synfinatic/sv650sds/sds_tool/sds_tool.kicad_pcb

## KiCad design sds_tool/sds_tool.kicad_pcb (2017-03-15)

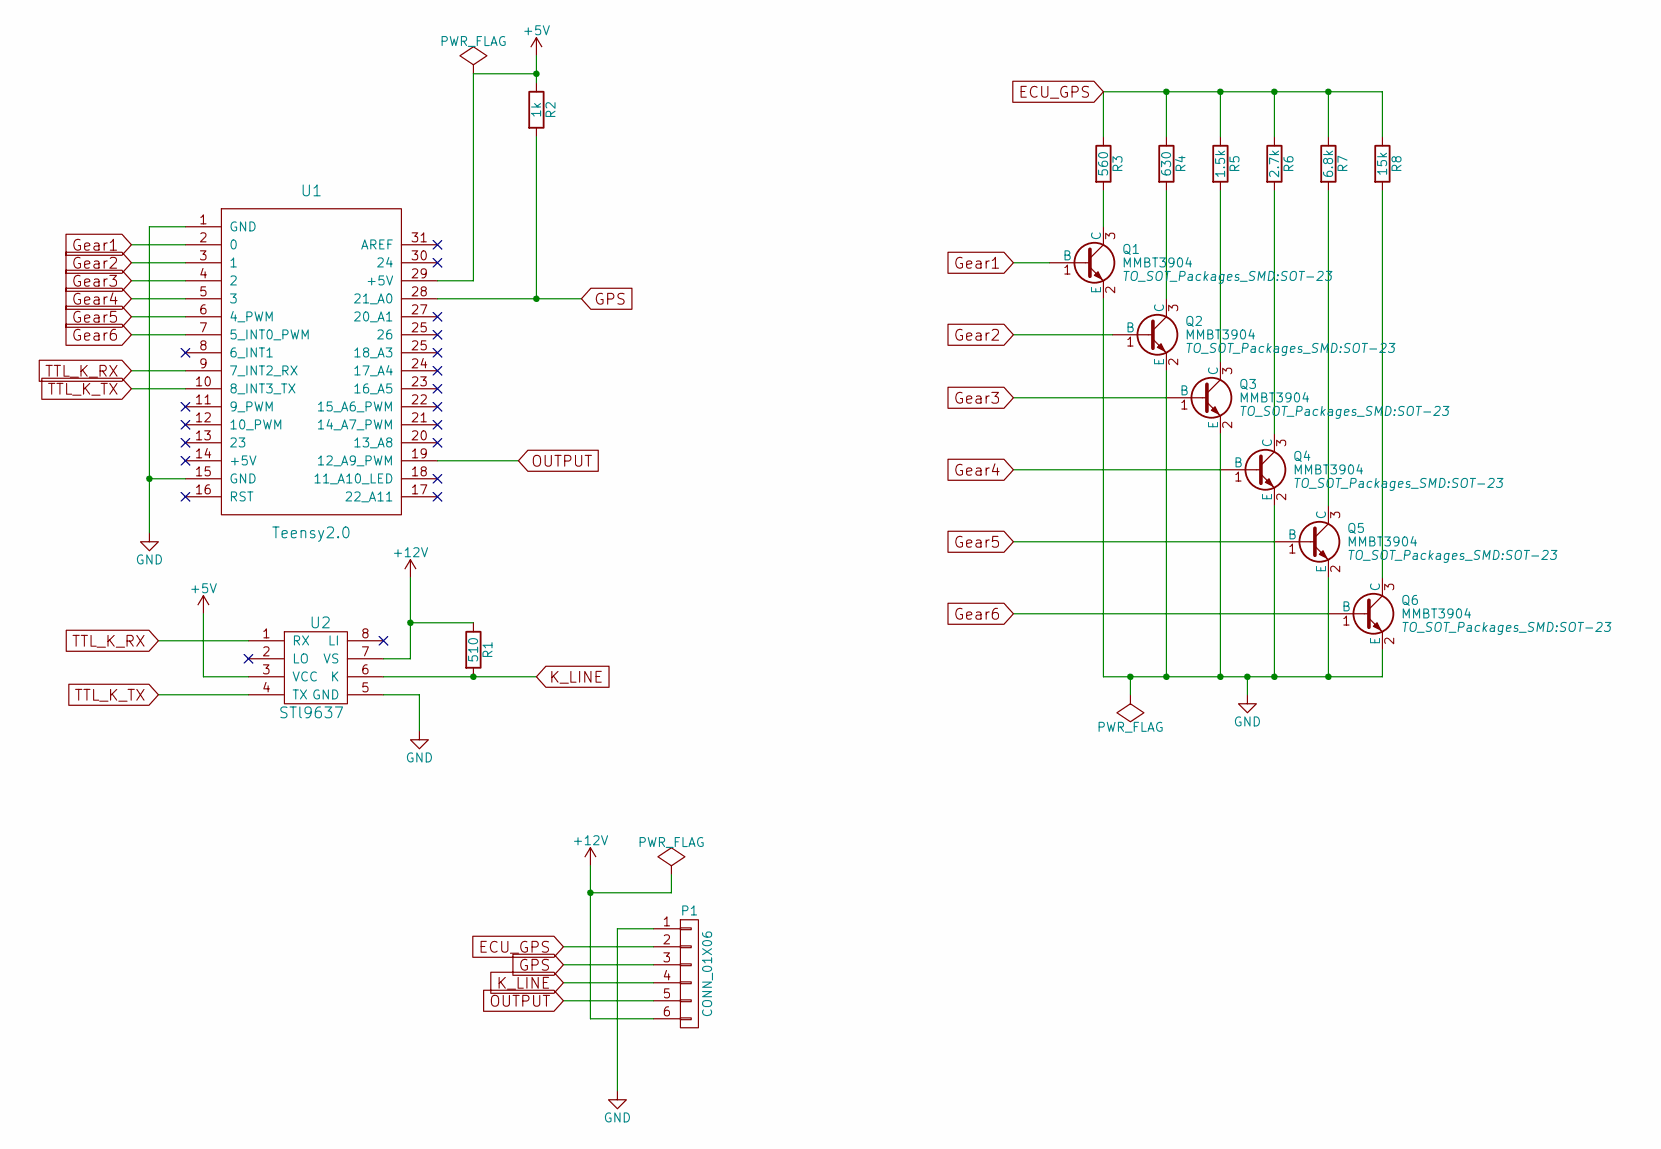
[picture p1: schematic sds_tool.sch, Suzuki SDS/GPS Tool]

Parts:
P1: CONN_01X06; TerminalBlock_Pheonix_PT-3.5mm_6pol
Q1, Q2, Q3, Q4, Q5, Q6: MMBT3904; SOT-23
R1: 510; R_0805_HandSoldering
R2: 1k; R_0805_HandSoldering
R3: 560; R_0805_HandSoldering
R4: 630; R_0805_HandSoldering
R5: 1.5k; R_0805_HandSoldering
R6: 2.7k; R_0805_HandSoldering
R7: 6.8k; R_0805_HandSoldering
R8: 15k; R_0805_HandSoldering
U1: Teensy2.0
U2: STl9637; SOIC-8_3.9x4.9mm_Pitch1.27mm

Connections:
+5V: R2.1, U1.29 (+5V), U2.3 (VCC)
+12V: P1.6, R1.1, U2.7 (VS)
ECU_GPS: P1.2, R3.1, R4.1, R5.1, R6.1, R7.1, R8.1
GND: P1.1, Q1.2 (E), Q2.2 (E), Q3.2 (E), Q4.2 (E), Q5.2 (E), Q6.2 (E), U1.1 (GND), U1.15 (GND), U2.5 (GND)
GPS: P1.3, R2.2, U1.28 (21_A0)
Gear1: Q1.1 (B), U1.2 (0)
Gear2: Q2.1 (B), U1.3 (1)
Gear3: Q3.1 (B), U1.4 (2)
Gear4: Q4.1 (B), U1.5 (3)
Gear5: Q5.1 (B), U1.6 (4_PWM)
Gear6: Q6.1 (B), U1.7 (5_INT0_PWM)
K_LINE: P1.4, R1.2, U2.6 (K)
unnamed: Q1.3 (C), R3.2
unnamed: Q2.3 (C), R4.2
unnamed: Q3.3 (C), R5.2
unnamed: Q4.3 (C), R6.2
unnamed: Q5.3 (C), R7.2
unnamed: Q6.3 (C), R8.2
OUTPUT: P1.5, U1.19 (12_A9_PWM)
TTL_K_RX: U1.9 (7_INT2_RX), U2.1 (RX)
TTL_K_TX: U1.10 (8_INT3_TX), U2.4 (TX)

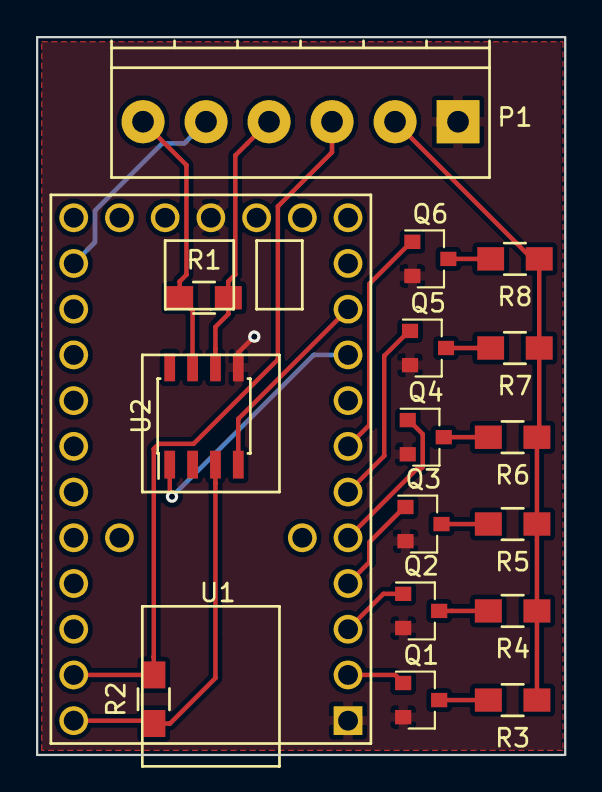
[picture p2: board sds_tool.kicad_pcb from above]

Board: 2 copper layers, 29.3 x 39.9 mm, 17 parts (0 on the bottom side), 21 nets.
