synfinatic/sv650sds/(threads)

Thread 1 (2018-04-05):

Socket pinout question

sergejey, 2018-04-05:
Hello,

I'm trying to make SDS reader for my SV650 (2003) but cannot find information about pinout in the diagnostic socket. Could you please help with socket pinout?

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

Thank you!

sergejey, 2018-04-05:
I think I found it :)
1. GND
2. K-line

Closed 2018-04-05.
