synfinatic/sv650sds/(commit log)

2016-05-20 Initial commit
    Readme with my notes so far.
    My initial OLS project file & csv
    [001-basic.csv]
2016-05-22 Create Teensy2.0 sds_tool for printing KWP-2000 messages on the K-Line
    Right now, we only support Teensy2.0, but adding other Arduino
    compatible boards should be super simple. Basically, this is just
    a passive listener on the K-Line/KWP-2000 protocol and just prints
    the messages to the USB Serial Console for debugging purposes.
2016-05-24 Major rewrite of sds_tool!
    This change makes it _much_ easier to add logic to decode messages.
    Just add an entry to a data struct and optionally write a function
    which can return the result as a string. Allows us to even decode
    a single value multiple ways with multiple formulas.
    The tool is still "passive" meaning it doesn't do a K-Line init
    so it still requires a SDS Tool to do all the talking.
    [PROGMEM_readAnything.h, sds_tool.h, sds_tool.ino, utils.h, utils.ino]
2017-01-29 add untested battery voltage code
    Untested. I've seen two different formulas out there
2017-03-12 add sds_print.ino and read_serial.py
    Realized that doing all the decoding in the Teensy was too painful.
    Using sds_print to handle the framing and only printing the messages
    from the ECU we are able to the decode them using read_serial.py
    Currently sds_print does not query the ECU so you will need an SDS Tool
    to do so.
2017-03-13 Big improvements to read_serial
    - Better decoding
    - Limits for what fields to decode
    - Turn on/off raw byte output
    - Print min/max for each field
2017-03-13 add sample read_serial output
2017-03-15 First pass at sds_tool PCB
    Supports the following features:
    - K-Line input
    - Gear position sensor input
    - Gear position sensor output
    - One general purpose I/O pin
    - Teensy 2.0 based
    [sds_tool-bom.csv, sds_tool.kicad_pcb, sds_tool.sch]
2017-04-15 Fix value of R4
    [sds_tool.sch]
